agustinBassi-others/juegoSimon/hard/README.md

CREACION DEL ARCHIVO: 30/06/16

AUTOR: Juan Agustin Bassi

Aclaraciones de caracter general para el proyecto "PONCHO SIMON" para la plataforma educativa EDU-CIAA NXP.
