agustinBassi-others/juegoSimon/hard/doc/PONCHO-SIMON Fotos/IMG_20170701_124607375.jpg

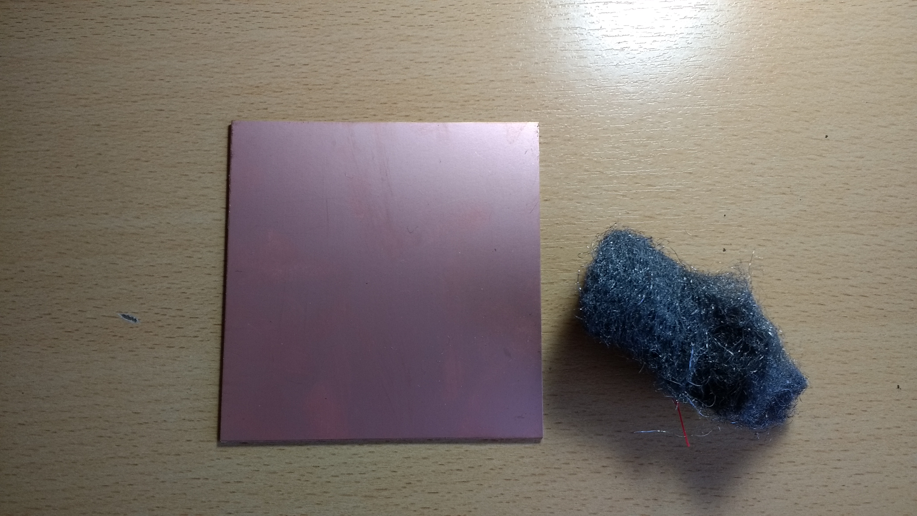
hard/doc/PONCHO-SIMON Fotos/IMG_20170701_124607375.jpg
