agustinBassi-others/juegoSimon/hard/doc/PONCHO-SIMON Fotos/IMG_20170701_125019360.jpg

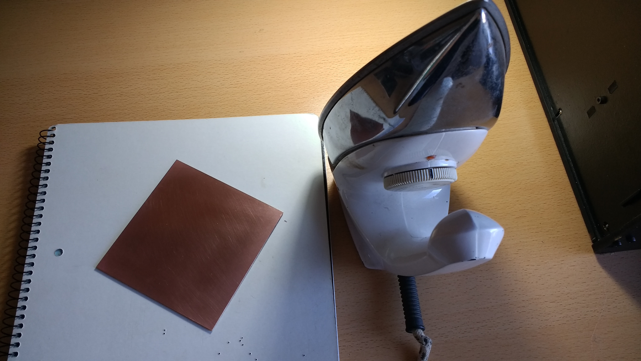
hard/doc/PONCHO-SIMON Fotos/IMG_20170701_125019360.jpg
