agustinBassi-others/juegoSimon/hard/doc/PONCHO-SIMON Fotos/IMG_20170701_125120024.jpg

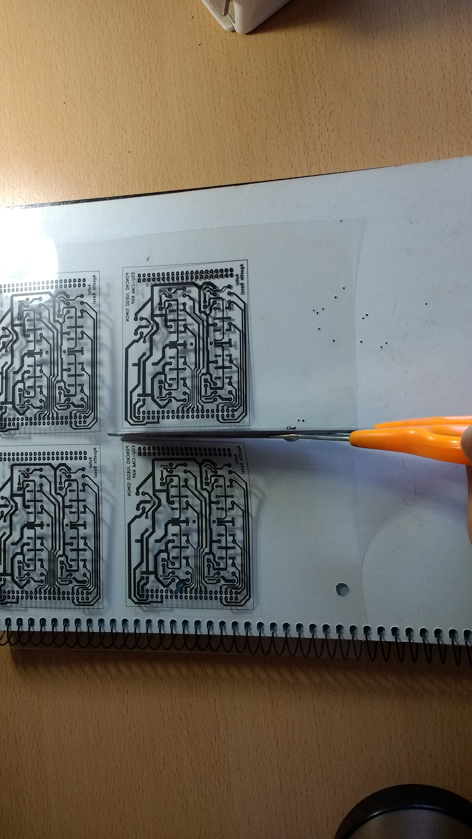
hard/doc/PONCHO-SIMON Fotos/IMG_20170701_125120024.jpg
