agustinBassi-others/juegoSimon/hard/doc/PONCHO-SIMON Fotos/IMG_20170701_125949578.jpg

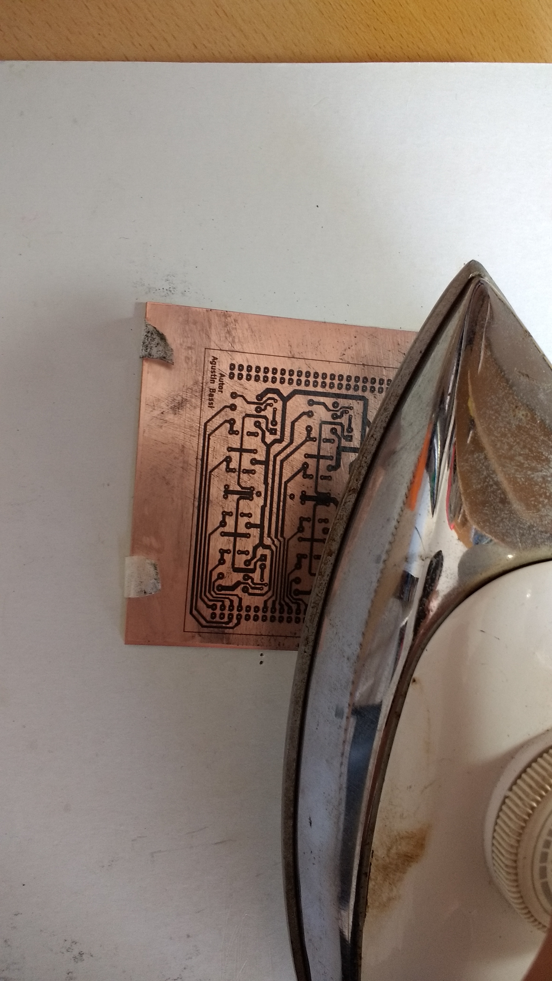
hard/doc/PONCHO-SIMON Fotos/IMG_20170701_125949578.jpg
