agustinBassi-others/juegoSimon/hard/doc/PONCHO-SIMON Fotos/IMG_20170701_130110849.jpg

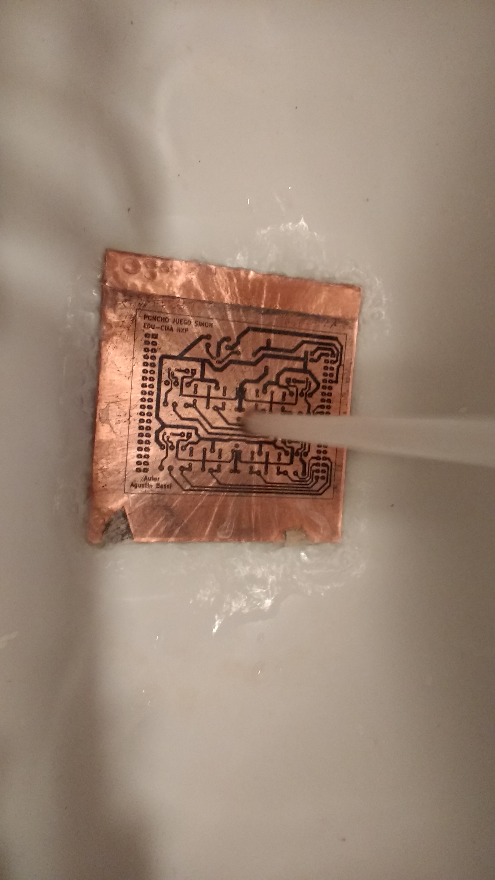
hard/doc/PONCHO-SIMON Fotos/IMG_20170701_130110849.jpg
