agustinBassi-others/juegoSimon/hard/doc/PONCHO-SIMON Fotos/IMG_20170701_134502179_HDR.jpg

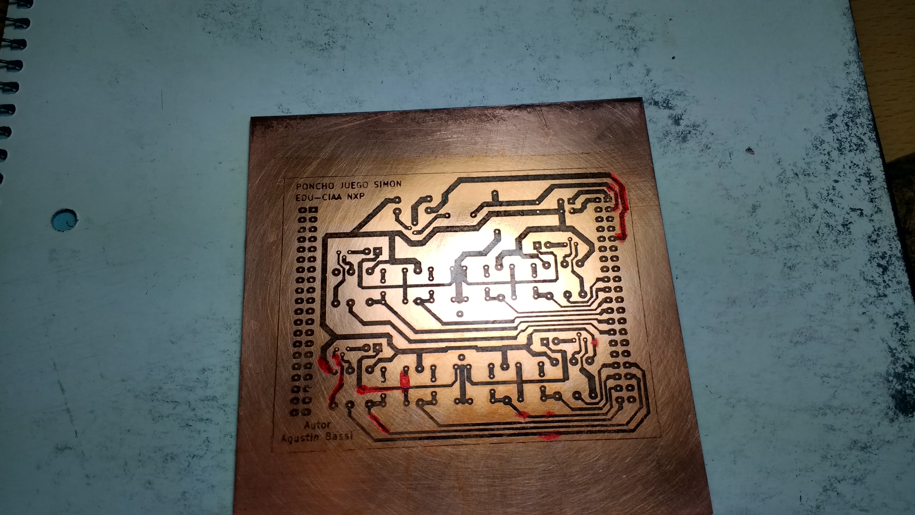
hard/doc/PONCHO-SIMON Fotos/IMG_20170701_134502179_HDR.jpg
