agustinBassi-others/juegoSimon/hard/doc/PONCHO-SIMON Fotos/IMG_20170701_150949867.jpg

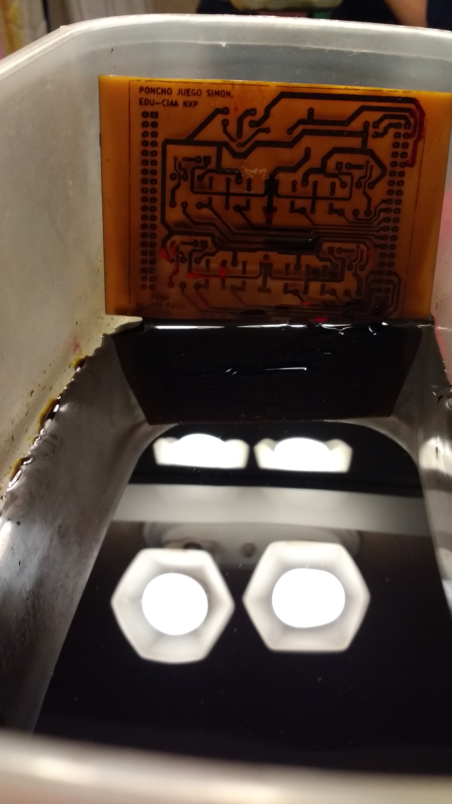
hard/doc/PONCHO-SIMON Fotos/IMG_20170701_150949867.jpg
