agustinBassi-others/juegoSimon/hard/doc/PONCHO-SIMON Fotos/IMG_20170701_150952031.jpg

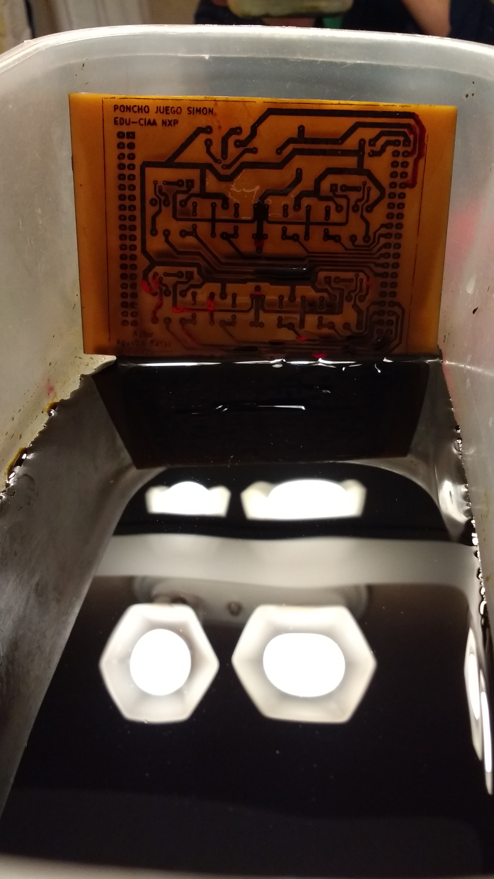
hard/doc/PONCHO-SIMON Fotos/IMG_20170701_150952031.jpg
