agustinBassi-others/juegoSimon/hard/doc/PONCHO-SIMON Fotos/IMG_20170701_153716362.jpg

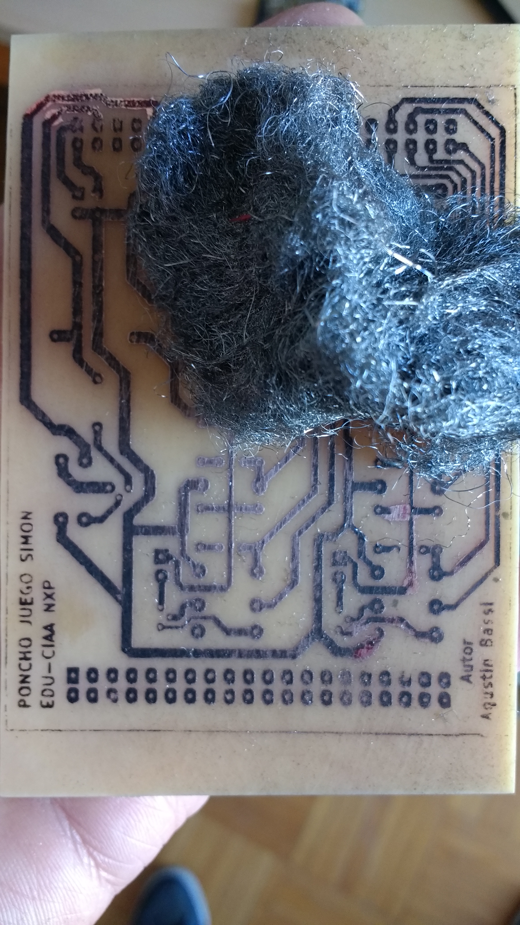
hard/doc/PONCHO-SIMON Fotos/IMG_20170701_153716362.jpg
