agustinBassi-others/juegoSimon/hard/doc/PONCHO-SIMON Fotos/IMG_20170701_154227787.jpg

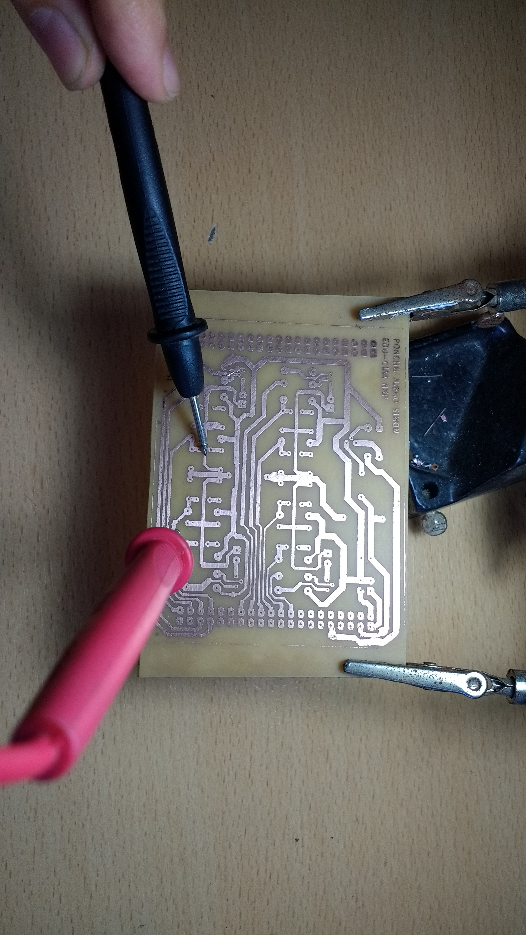
hard/doc/PONCHO-SIMON Fotos/IMG_20170701_154227787.jpg
