agustinBassi-others/juegoSimon/hard/doc/PONCHO-SIMON Fotos/IMG_20170701_154240591.jpg

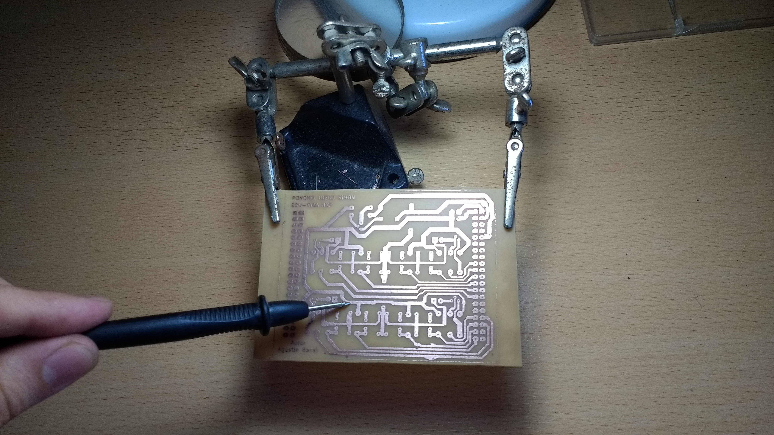
hard/doc/PONCHO-SIMON Fotos/IMG_20170701_154240591.jpg
