agustinBassi-others/juegoSimon/hard/doc/PONCHO-SIMON Fotos/IMG_20170701_154302212.jpg

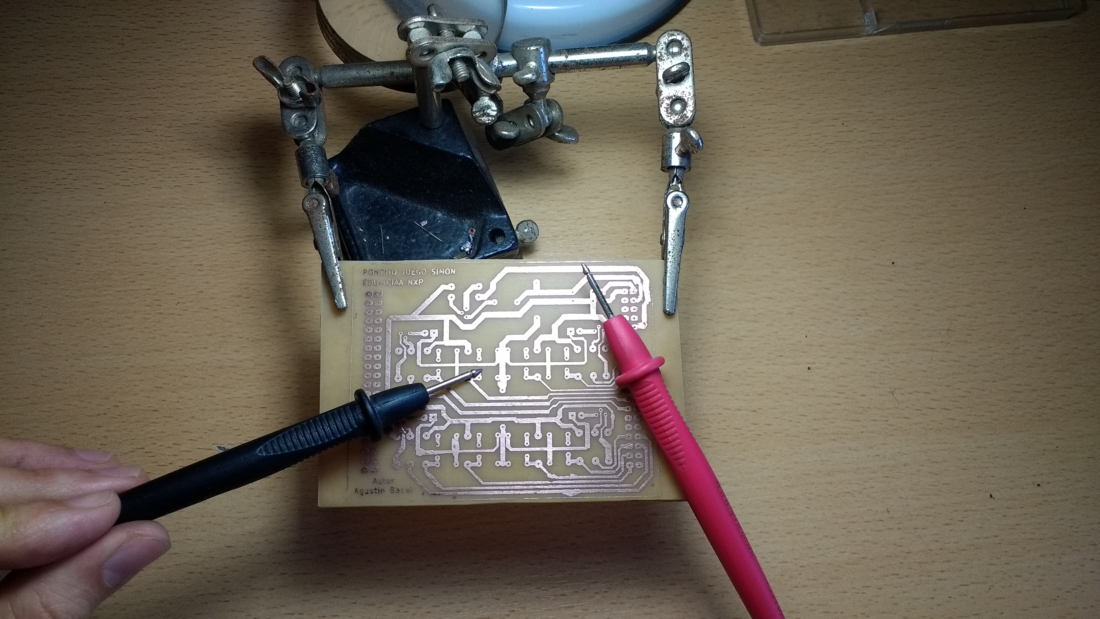
hard/doc/PONCHO-SIMON Fotos/IMG_20170701_154302212.jpg
