agustinBassi-others/juegoSimon/hard/doc/PONCHO-SIMON Fotos/IMG_20170701_155407084.jpg

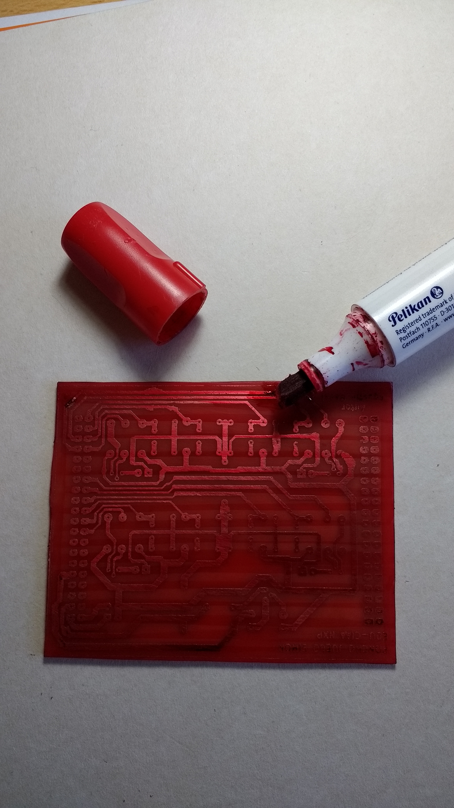
hard/doc/PONCHO-SIMON Fotos/IMG_20170701_155407084.jpg
