agustinBassi-others/juegoSimon/hard/doc/PONCHO-SIMON Fotos/IMG_20170701_160003460.jpg

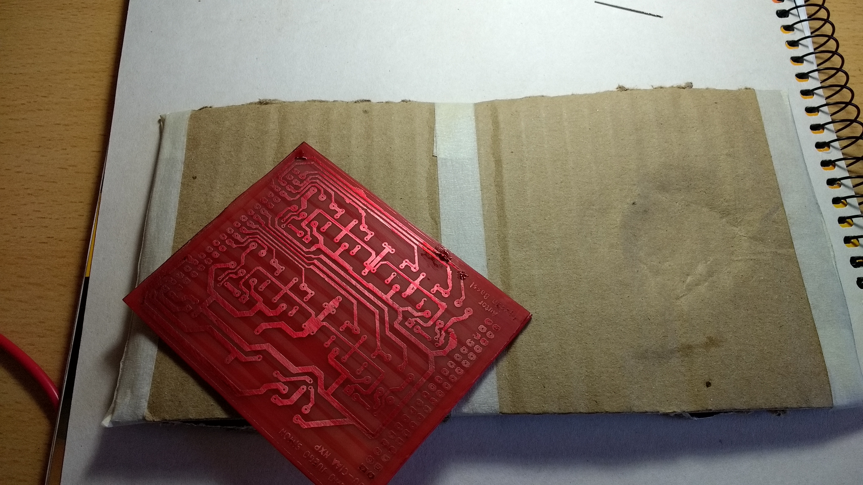
hard/doc/PONCHO-SIMON Fotos/IMG_20170701_160003460.jpg
