agustinBassi-others/juegoSimon/hard/doc/PONCHO-SIMON Fotos/IMG_20170701_162618793.jpg

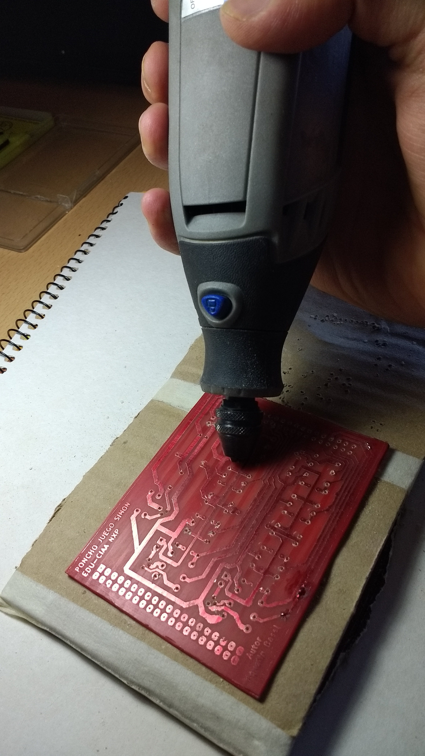
hard/doc/PONCHO-SIMON Fotos/IMG_20170701_162618793.jpg
