agustinBassi-others/juegoSimon/hard/doc/PONCHO-SIMON Fotos/IMG_20170701_185001587.jpg

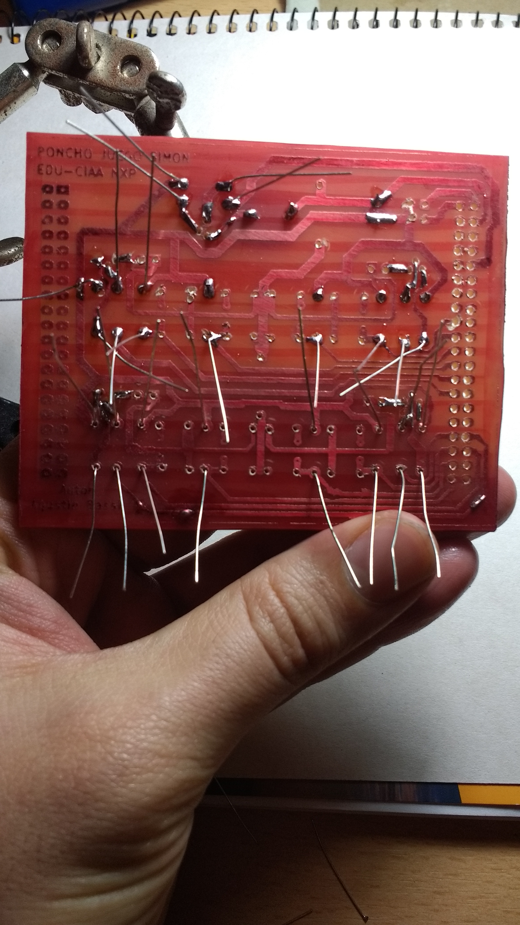
hard/doc/PONCHO-SIMON Fotos/IMG_20170701_185001587.jpg
