agustinBassi-others/juegoSimon/hard/doc/PONCHO-SIMON Fotos/IMG_20170701_185011305_HDR.jpg

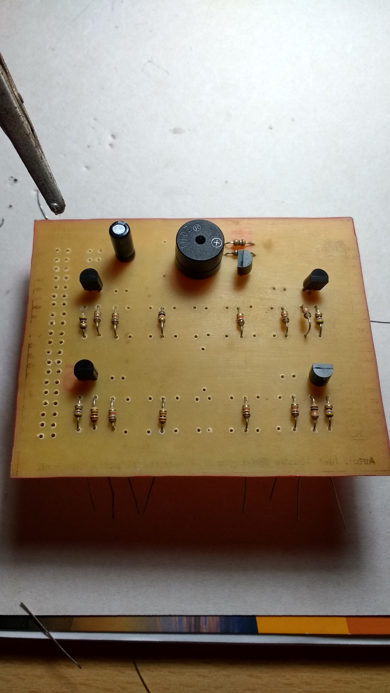
hard/doc/PONCHO-SIMON Fotos/IMG_20170701_185011305_HDR.jpg
