agustinBassi-others/juegoSimon/hard/doc/PONCHO-SIMON Fotos/IMG_20170701_233252299.jpg

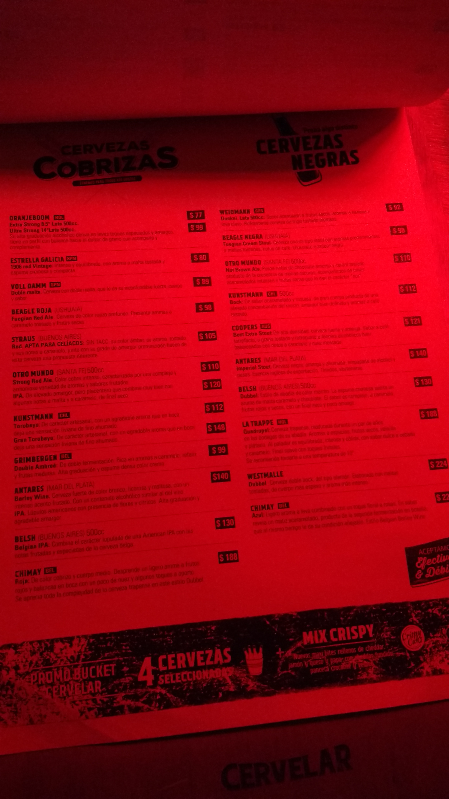
hard/doc/PONCHO-SIMON Fotos/IMG_20170701_233252299.jpg
