agustinBassi-others/juegoSimon/hard/doc/PONCHO-SIMON Fotos/IMG_20170701_233353394.jpg

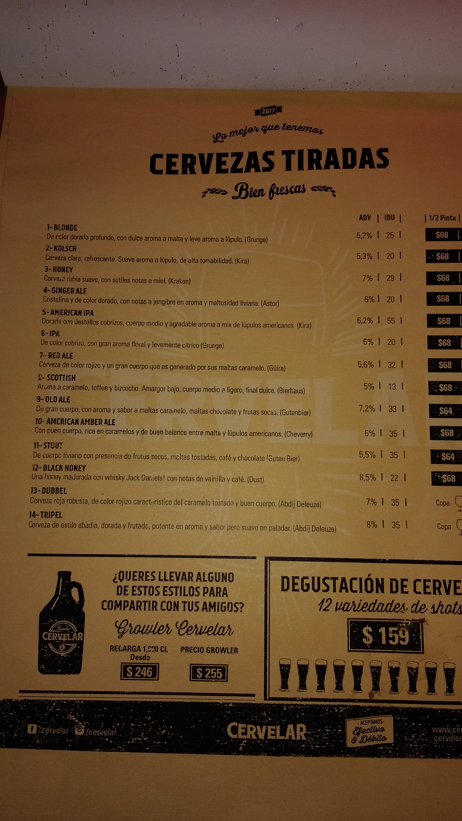
hard/doc/PONCHO-SIMON Fotos/IMG_20170701_233353394.jpg
