agustinBassi-others/juegoSimon/hard/doc/PONCHO-SIMON Fotos/IMG_20170702_172156348.jpg

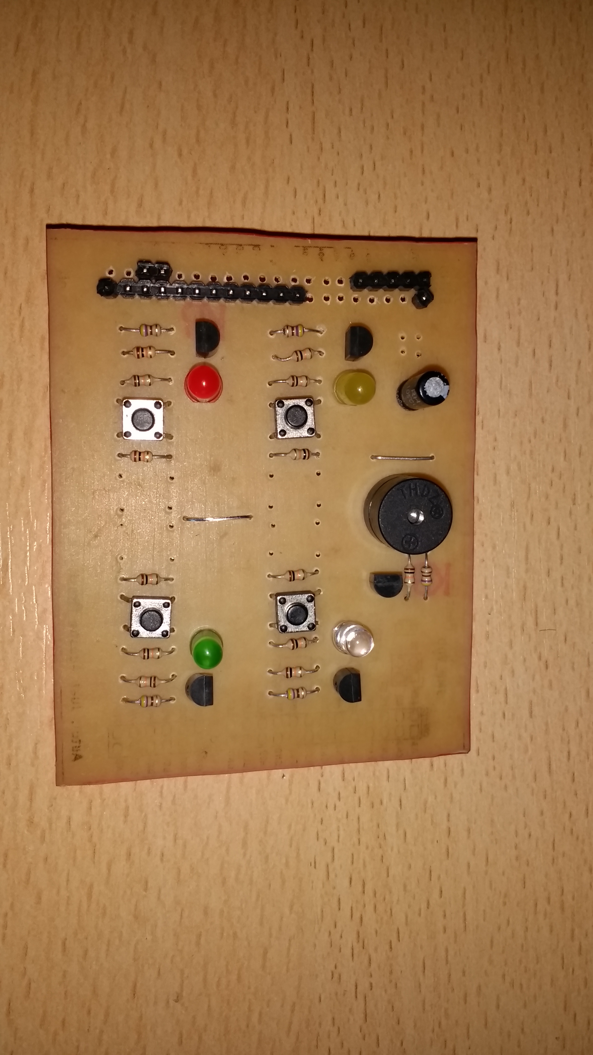
hard/doc/PONCHO-SIMON Fotos/IMG_20170702_172156348.jpg
