agustinBassi-others/juegoSimon/hard/doc/PONCHO-SIMON Fotos/IMG_20170702_172204577.jpg

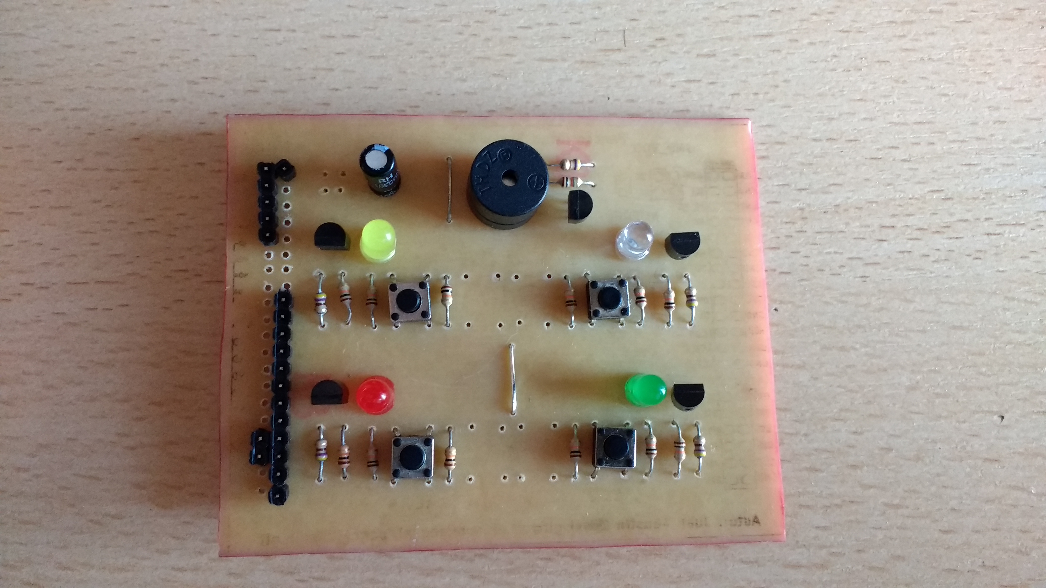
hard/doc/PONCHO-SIMON Fotos/IMG_20170702_172204577.jpg
