agustinBassi-others/juegoSimon/hard/doc/PONCHO-SIMON Fotos/IMG_20170702_184306553.jpg

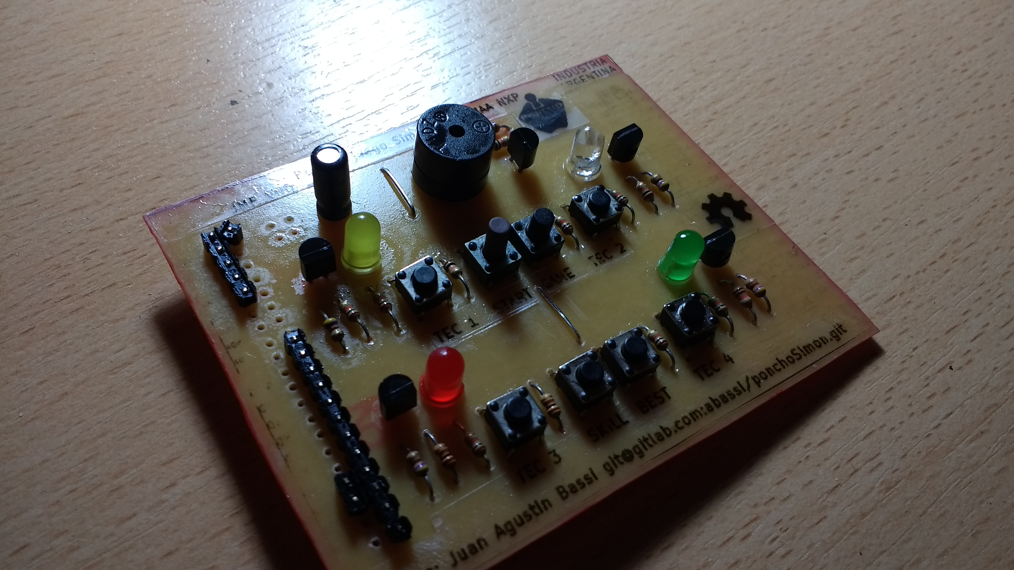
hard/doc/PONCHO-SIMON Fotos/IMG_20170702_184306553.jpg
