agustinBassi-others/juegoSimon/hard/doc/PONCHO-SIMON Fotos/IMG_20170702_184310411.jpg

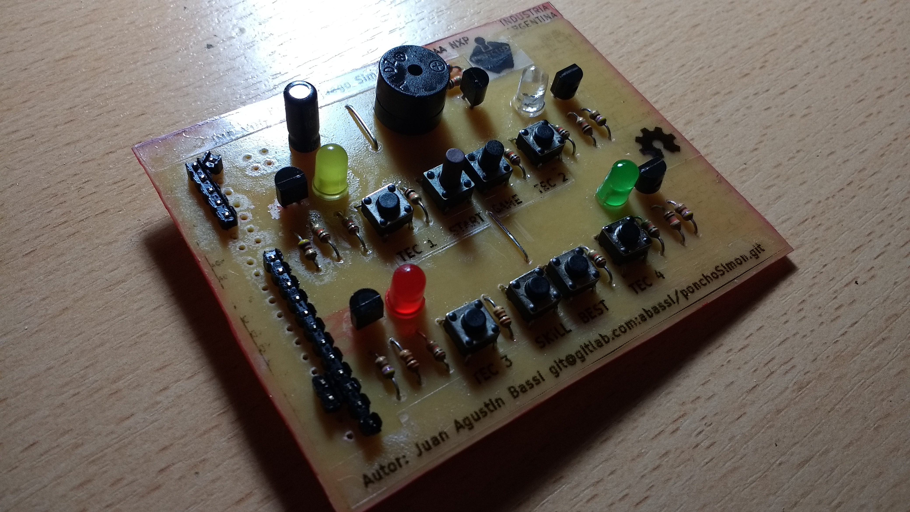
hard/doc/PONCHO-SIMON Fotos/IMG_20170702_184310411.jpg
