agustinBassi-others/juegoSimon/hard/doc/PONCHO-SIMON Fotos/IMG_20170702_185251613.jpg

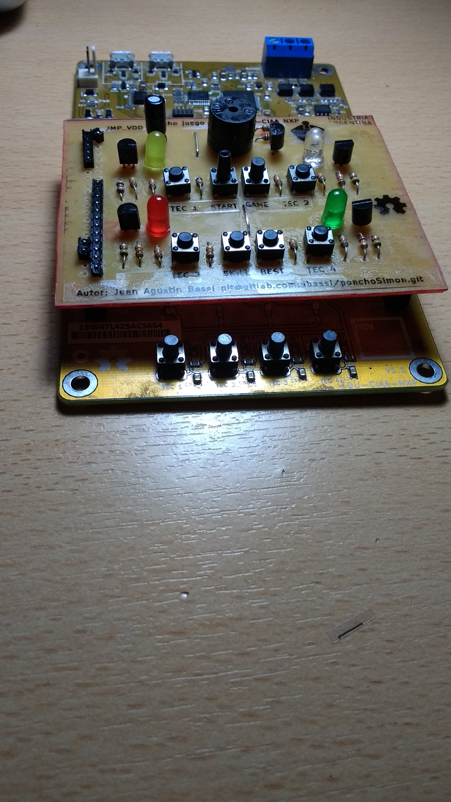
hard/doc/PONCHO-SIMON Fotos/IMG_20170702_185251613.jpg
