agustinBassi-others/juegoSimon/hard/doc/schematic.pdf

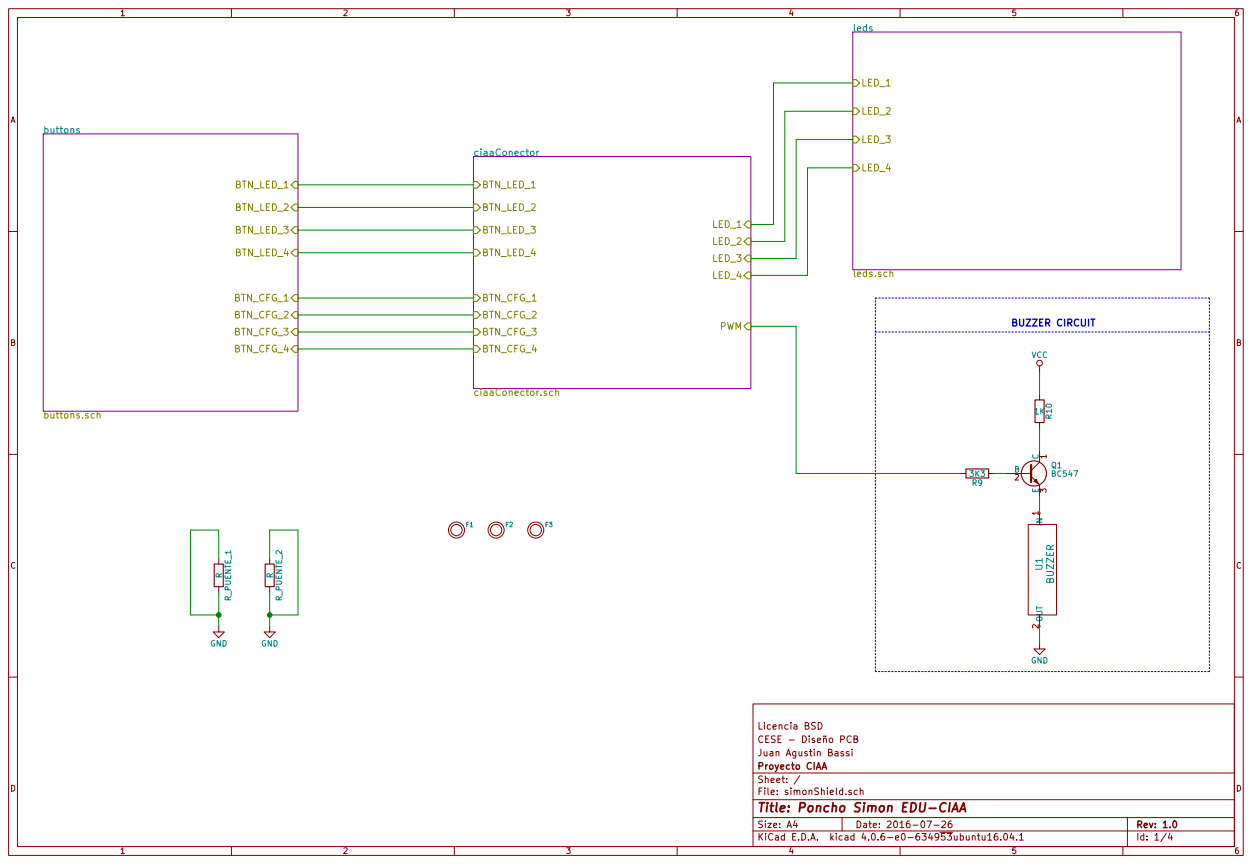
[picture p44: page 1]

Licencia BSD
Juan Agustin Bassi CESE - Diseño PCB

File: simonShield.sch Sheet: / Proyecto CIAA

Id: 1/4 Title: Poncho Simon EDU-CIAA

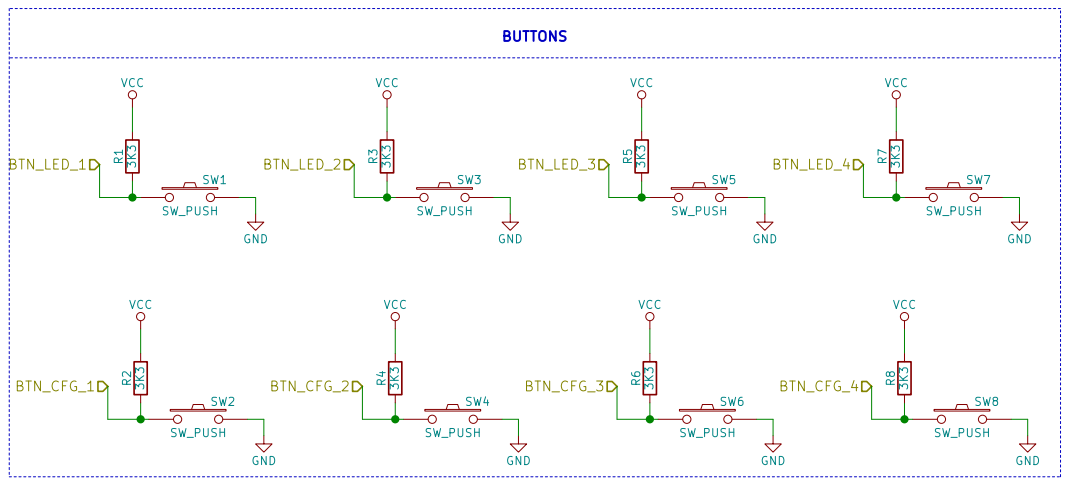
[picture p45: page 2]

Licencia BSD
Juan Agustin Bassi CESE - Diseño PCB

File: buttons.sch Sheet: /buttons/ Proyecto CIAA

Id: 2/4 Title: Poncho Simon EDU-CIAA

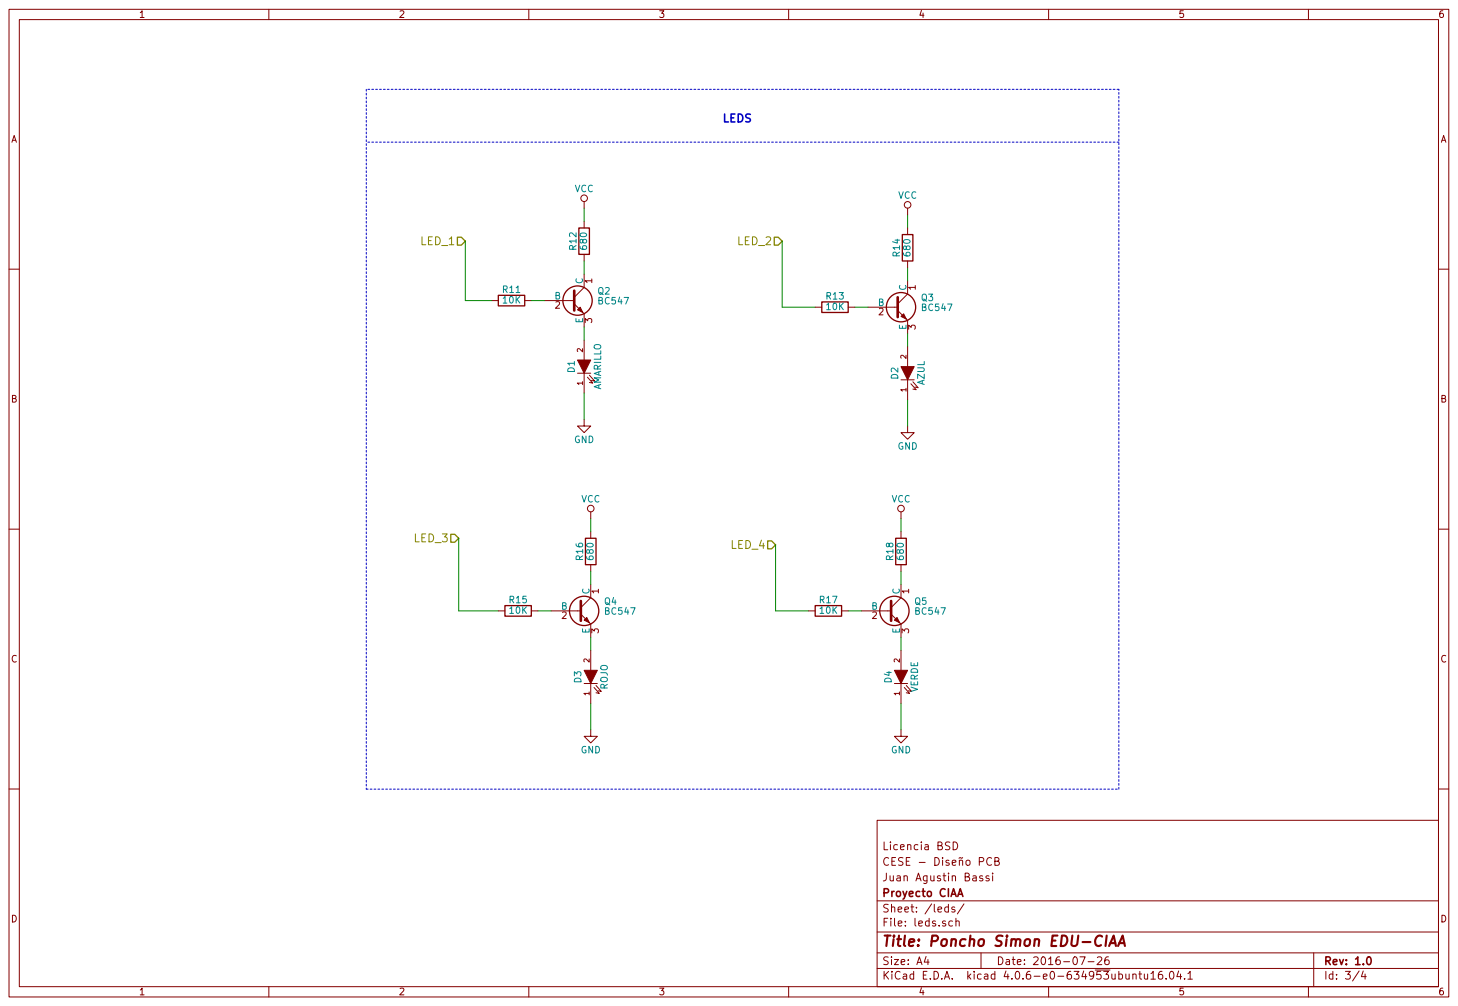
[picture p46: page 3]

Licencia BSD
Juan Agustin Bassi CESE - Diseño PCB

File: leds.sch Sheet: /leds/ Proyecto CIAA

Id: 3/4 Title: Poncho Simon EDU-CIAA

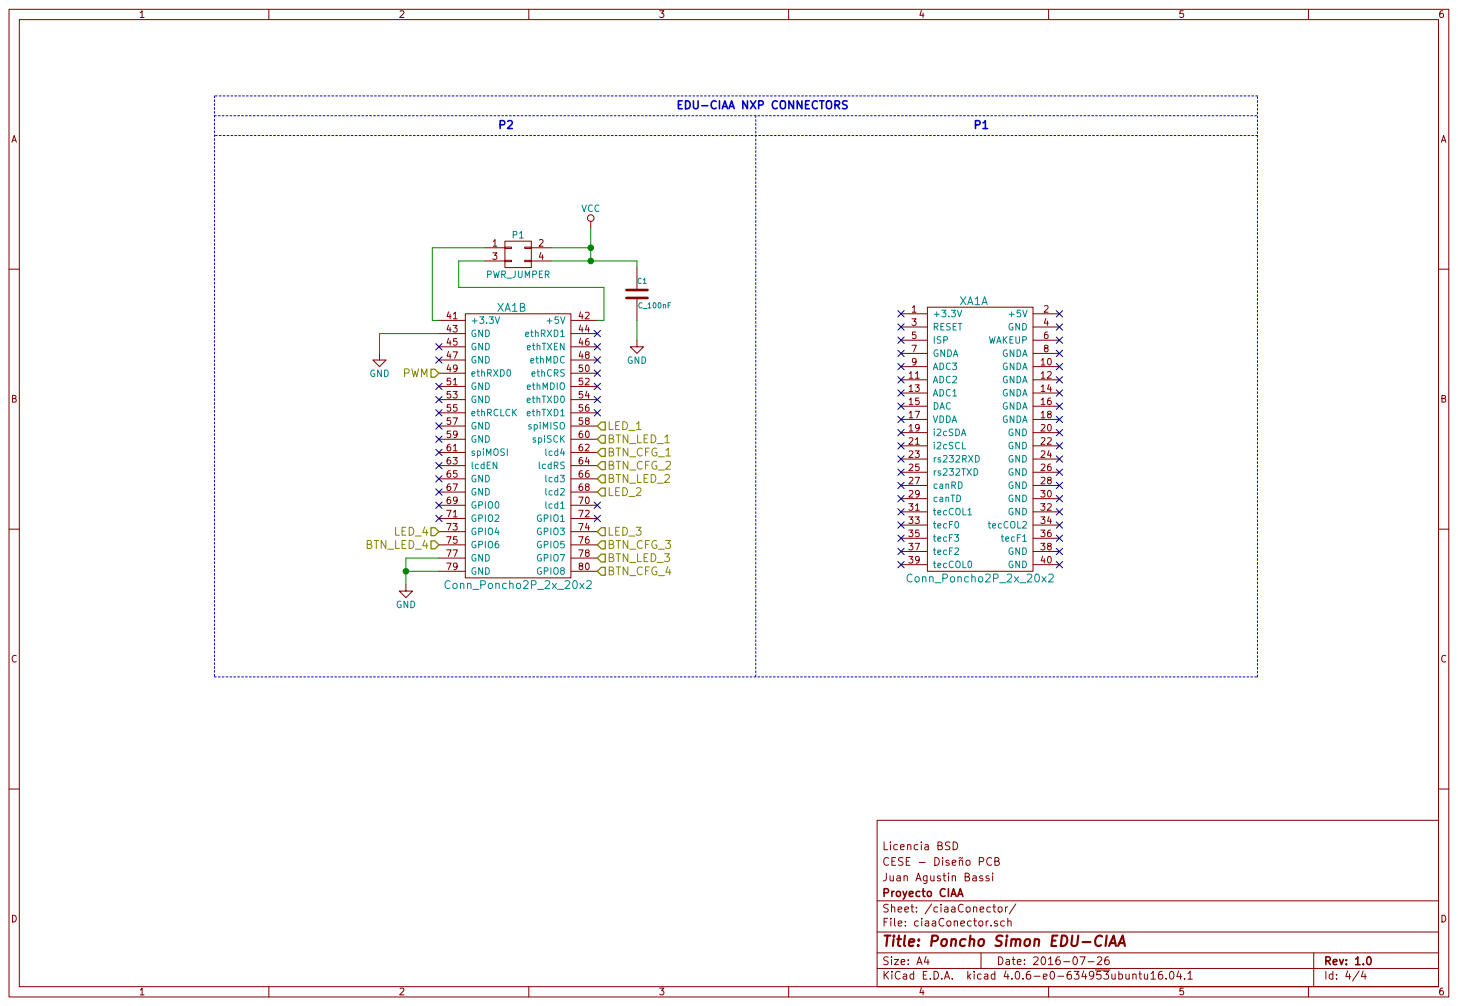
[picture p47: page 4]

EDU-CIAA NXP CONNECTORS

Licencia BSD
Juan Agustin Bassi CESE - Diseño PCB

File: ciaaConector.sch Sheet: /ciaaConector/ Proyecto CIAA

Id: 4/4 Title: Poncho Simon EDU-CIAA
