agustinBassi-others/juegoSimon/hard/gerber/pdf/simonShield-F.SilkS_x6.pdf

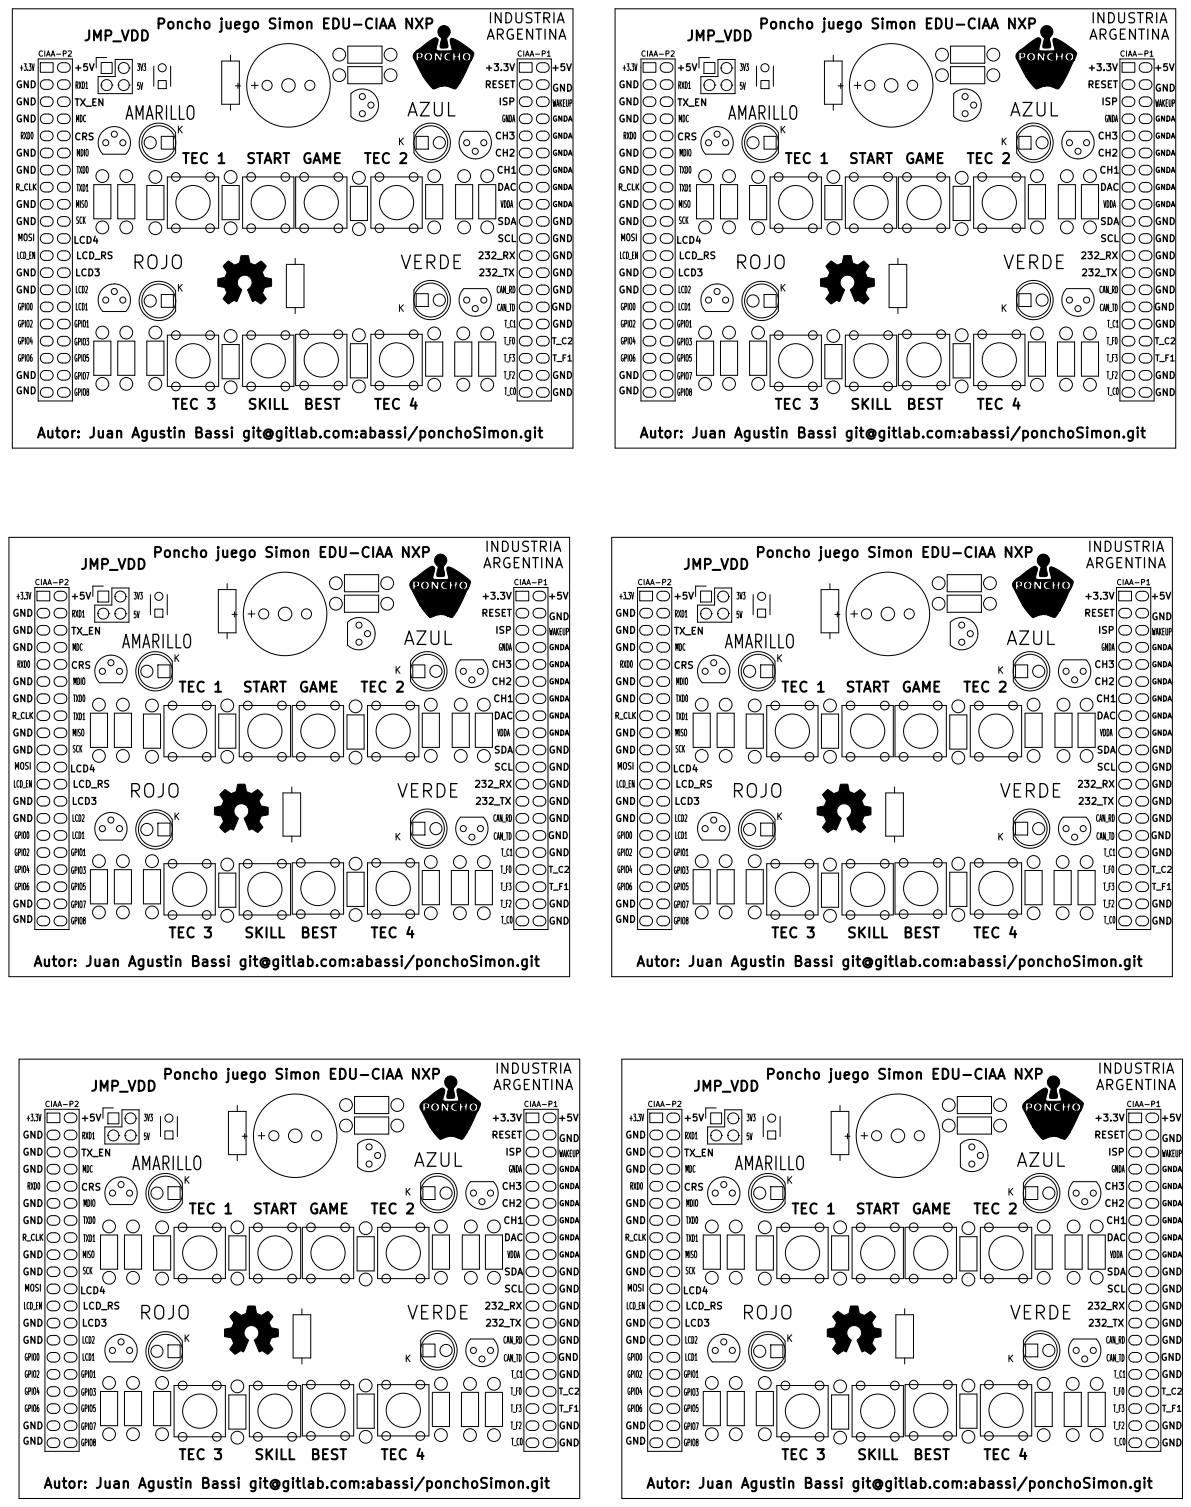
[picture p48: page 1]

INDUSTRIA
ARGENTINA
RXD1 +5V GND GND GPIO6 GPIO4 GPIO2 GPIO0 GND GND
RXD0 GND GND
R_CLK GND GND GND
K GPIO8 GPIO7 GPIO5 GPIO3 GPIO1 LCD1 LCD2 LCD3 LCD_RS
Autor: Juan Agustin Bassi git@gitlab.com:abassi/ponchoSimon.git START GAME

Poncho juego Simon EDU-CIAA NXP

ARGENTINA AMARILLO
JMP_VDD

GNDA GNDA GNDA GNDA GNDA GNDA WAKEUP GND

DAC
VDDA
T_F1 T_C2 GND GND GND GND GND GND GND
