agustinBassi-others/juegoSimon/hard/gerber/pdf/simonShield-B.Cu_x6.pdf

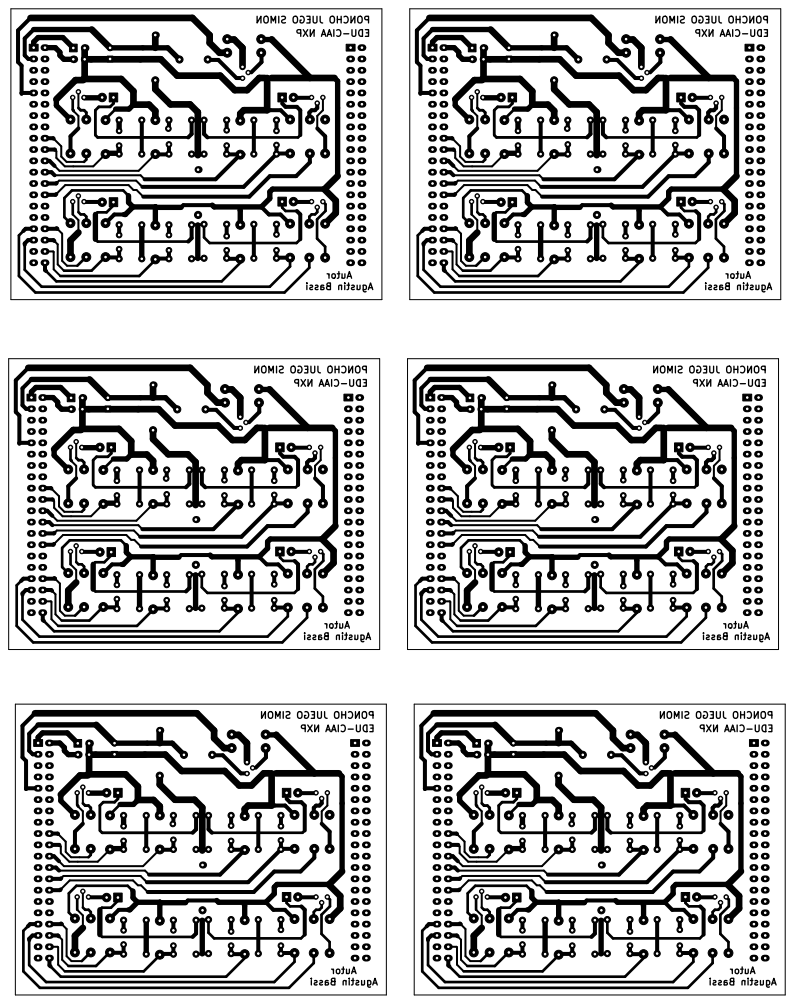
[picture p49: page 1]

EDU-CIAA NXP Autor Agustin Bassi Autor Agustin Bassi EDU-CIAA NXP
