agustinBassi-others/juegoSimon/hard/simonShield.kicad_pcb

## KiCad design hard/simonShield.kicad_pcb (2017-07-07)

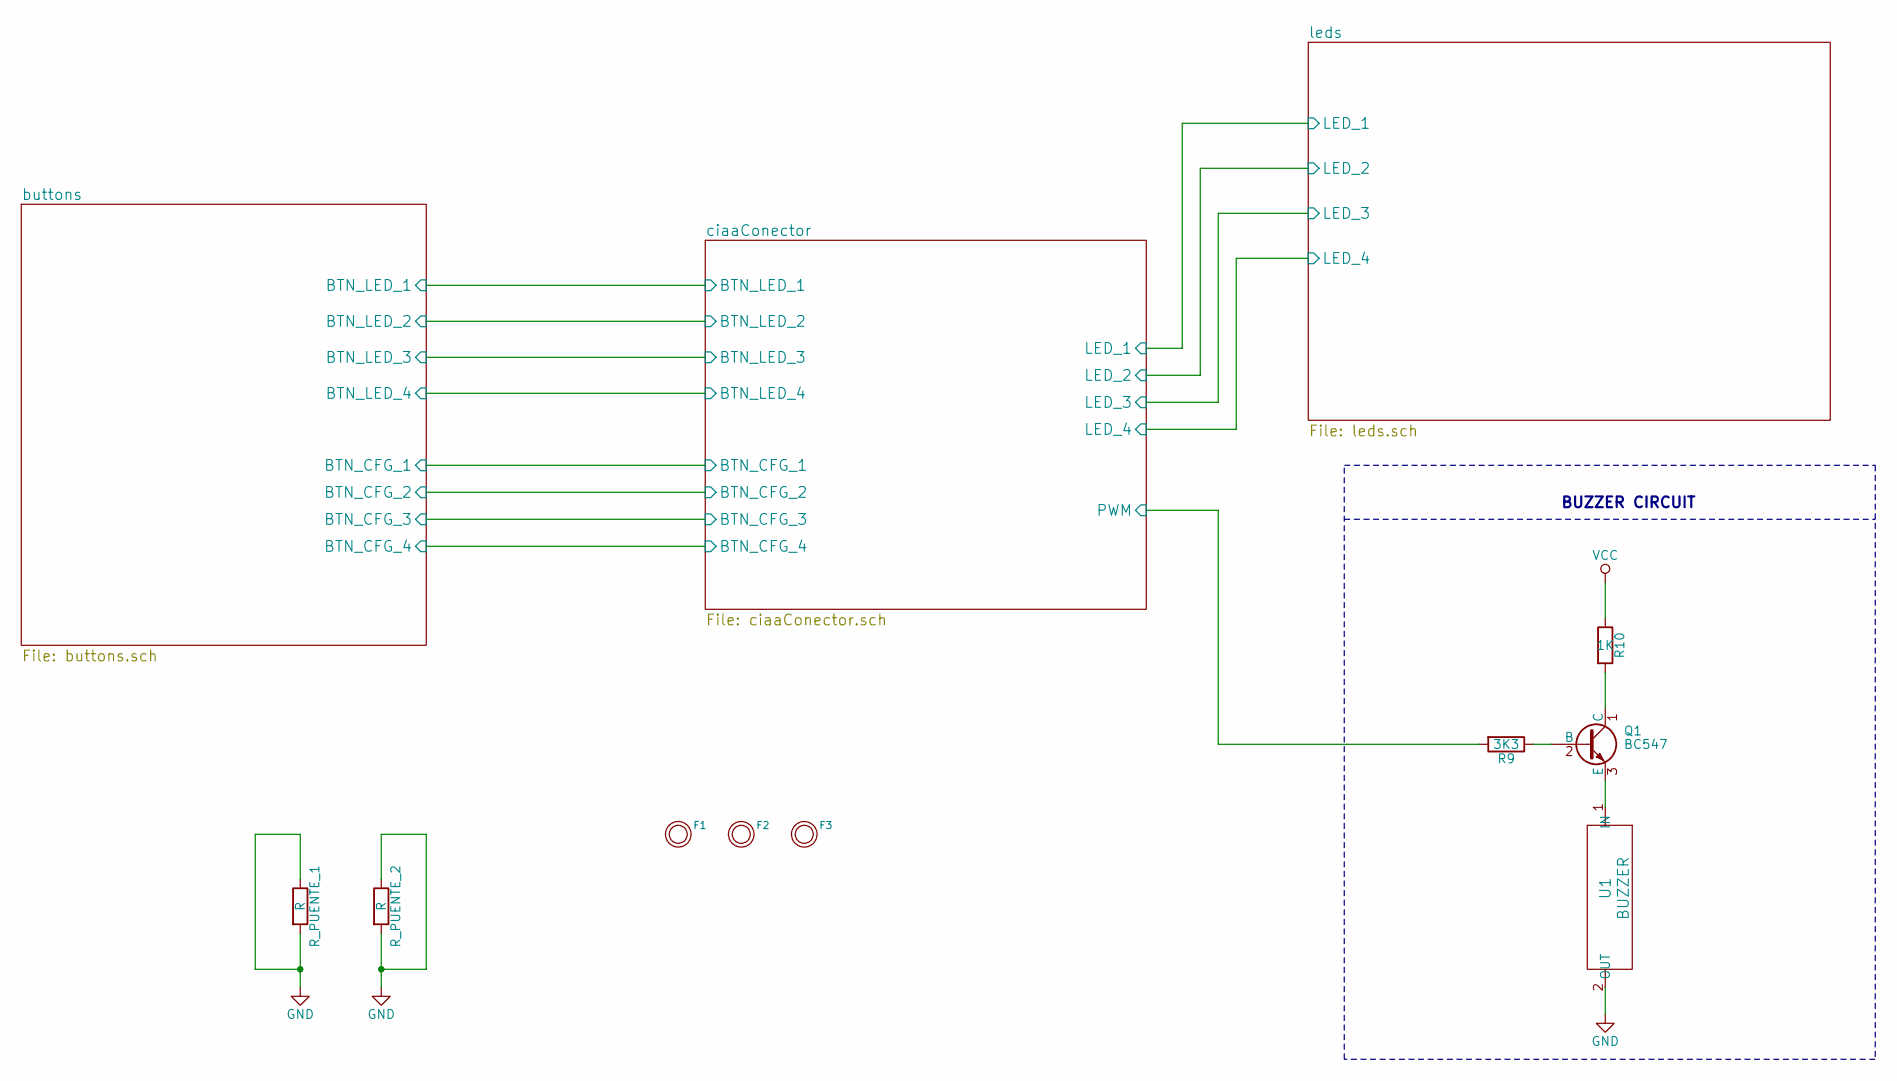
[picture p51: schematic simonShield.sch, Poncho Simon EDU-CIAA]

Parts:
F1, F2, F3: FIDUCIAL; Fiducial_1mm
Q1: BC547; TO-92_Molded_Narrow; Digikey# BC33725TACT-ND
R9: 3K3; Resistor_Horizontal_RM7mm; Digikey# 680EBK-ND
R10: 1K; Resistor_Horizontal_RM7mm; Digikey# 680EBK-ND
R_PUENTE_1, R_PUENTE_2: R; R_Axial_DIN0207_L6.3mm_D2.5mm_P10.16mm_Horizontal
U1: BUZZER; MagneticBuzzer_ProSignal_ABT-410-RC; Digikey# 445-2525-1-ND

Connections:
/ciaaConector/PWM: R9.2; also elsewhere on the board
GND: R_PUENTE_1.1, R_PUENTE_1.2, R_PUENTE_2.1, R_PUENTE_2.2, U1.2 (OUT); also elsewhere on the board
unnamed: Q1.1 (C), R10.2
unnamed: Q1.2 (B), R9.1
unnamed: Q1.3 (E), U1.1 (IN)
VCC: R10.1; also elsewhere on the board

Notes on the sheet:
BUZZER CIRCUIT

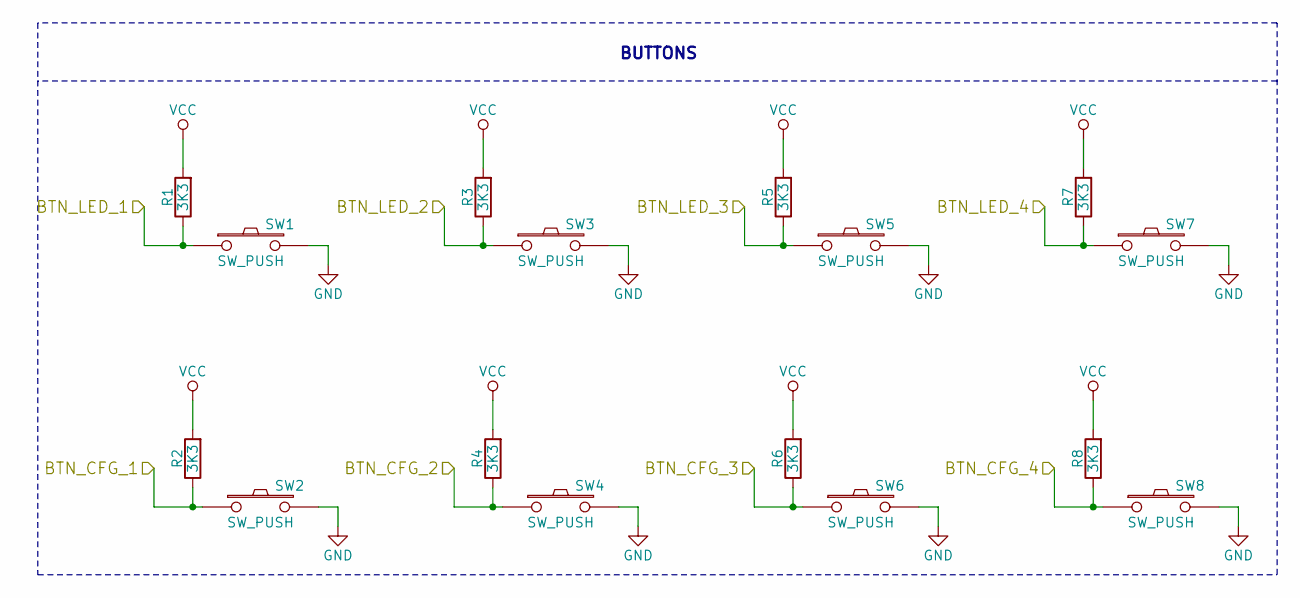
[picture p52: schematic buttons.sch, Poncho Simon EDU-CIAA]

Parts:
R1, R2, R3, R4, R5, R6, R7, R8: 3K3; Resistor_Horizontal_RM7mm; Digikey# 680EBK-ND
SW1, SW2, SW3, SW4, SW5, SW6, SW7, SW8: SW_PUSH; SW_PUSH_SMALL; Digikey# 450-1804-ND

Connections:
/buttons/BTN_CFG_1: R2.1, SW2.1; also elsewhere on the board
/buttons/BTN_CFG_2: R4.1, SW4.1; also elsewhere on the board
/buttons/BTN_CFG_3: R6.1, SW6.1; also elsewhere on the board
/buttons/BTN_CFG_4: R8.1, SW8.1; also elsewhere on the board
/buttons/BTN_LED_1: R1.1, SW1.1; also elsewhere on the board
/buttons/BTN_LED_2: R3.1, SW3.1; also elsewhere on the board
/buttons/BTN_LED_3: R5.1, SW5.1; also elsewhere on the board
/buttons/BTN_LED_4: R7.1, SW7.1; also elsewhere on the board
GND: SW1.2, SW2.2, SW3.2, SW4.2, SW5.2, SW6.2, SW7.2, SW8.2; also elsewhere on the board
VCC: R1.2, R2.2, R3.2, R4.2, R5.2, R6.2, R7.2, R8.2; also elsewhere on the board

Notes on the sheet:
BUTTONS

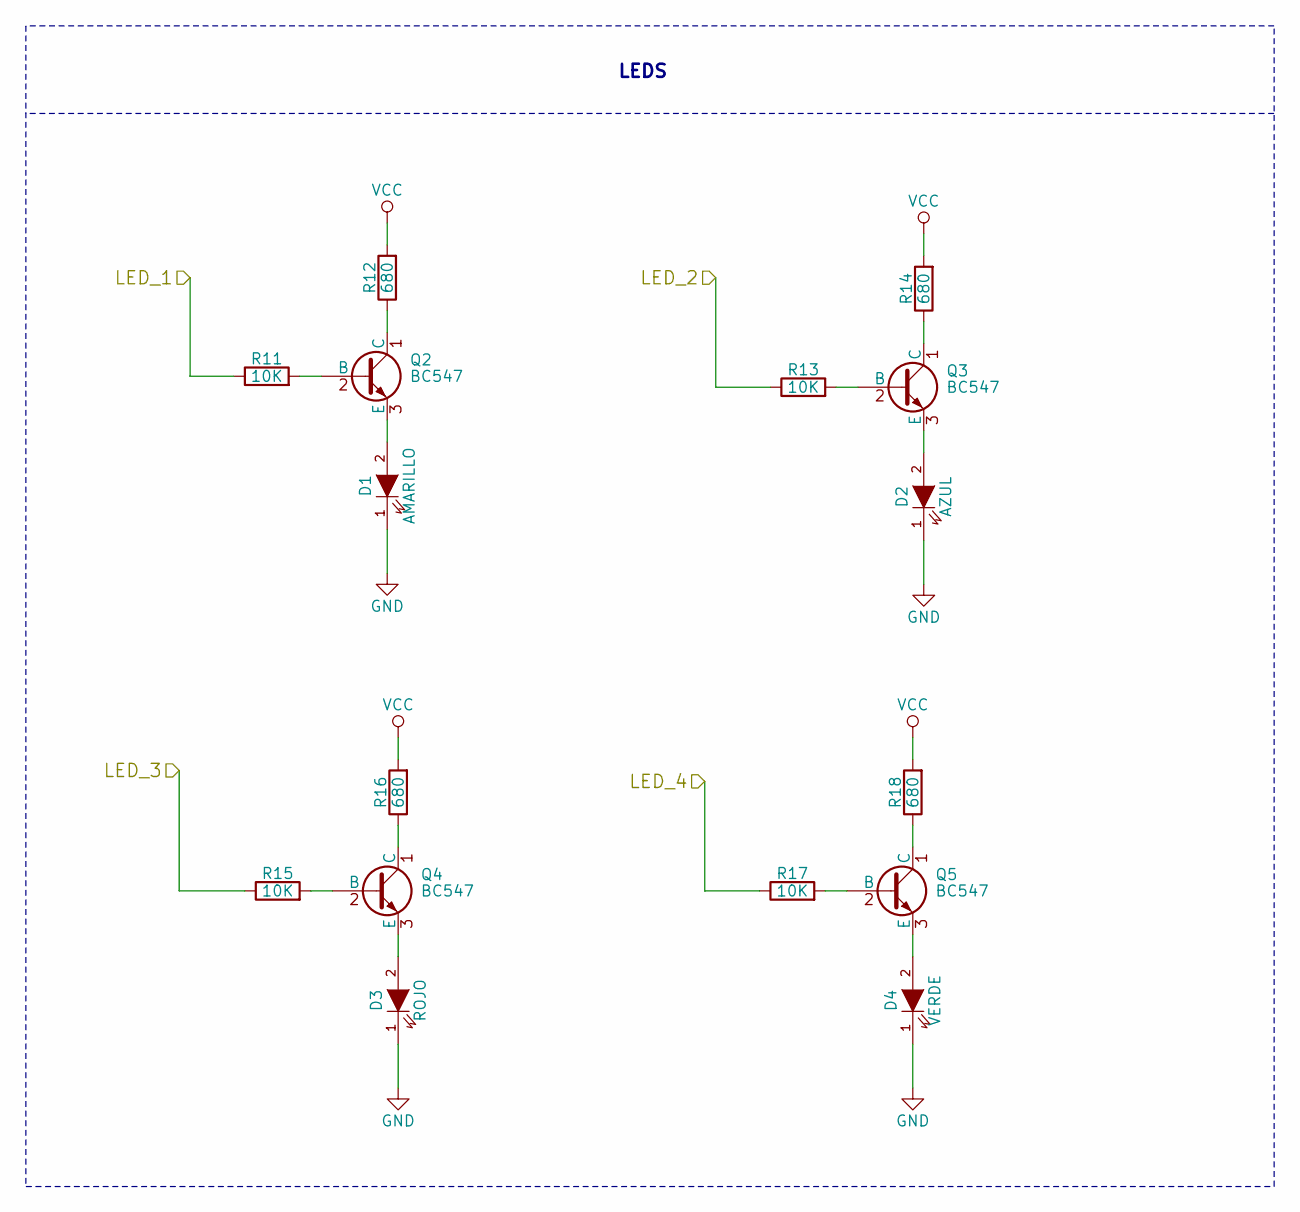
[picture p53: schematic leds.sch, Poncho Simon EDU-CIAA]

Parts:
D1: AMARILLO; LED-5MM; Digikey# 1497-1031-ND
D2: AZUL; LED-5MM; Digikey# 1497-1031-ND
D3: ROJO; LED-5MM; Digikey# 1497-1031-ND
D4: VERDE; LED-5MM; Digikey# 1497-1031-ND
Q2, Q3, Q4, Q5: BC547; TO-92_Molded_Narrow; Digikey# BC33725TACT-ND
R11, R13, R15, R17: 10K; Resistor_Horizontal_RM7mm; Digikey# 680EBK-ND
R12, R14, R16, R18: 680; Resistor_Horizontal_RM7mm; Digikey# 680EBK-ND

Connections:
/ciaaConector/LED_1: R11.1; also elsewhere on the board
/ciaaConector/LED_2: R13.1; also elsewhere on the board
/ciaaConector/LED_3: R15.1; also elsewhere on the board
/ciaaConector/LED_4: R17.1; also elsewhere on the board
GND: D1.1 (K), D2.1 (K), D3.1 (K), D4.1 (K); also elsewhere on the board
unnamed: D1.2 (A), Q2.3 (E)
unnamed: D2.2 (A), Q3.3 (E)
unnamed: D3.2 (A), Q4.3 (E)
unnamed: D4.2 (A), Q5.3 (E)
unnamed: Q2.1 (C), R12.1
unnamed: Q2.2 (B), R11.2
unnamed: Q3.1 (C), R14.1
unnamed: Q3.2 (B), R13.2
unnamed: Q4.1 (C), R16.1
unnamed: Q4.2 (B), R15.2
unnamed: Q5.1 (C), R18.1
unnamed: Q5.2 (B), R17.2
VCC: R12.2, R14.2, R16.2, R18.2; also elsewhere on the board

Notes on the sheet:
LEDS

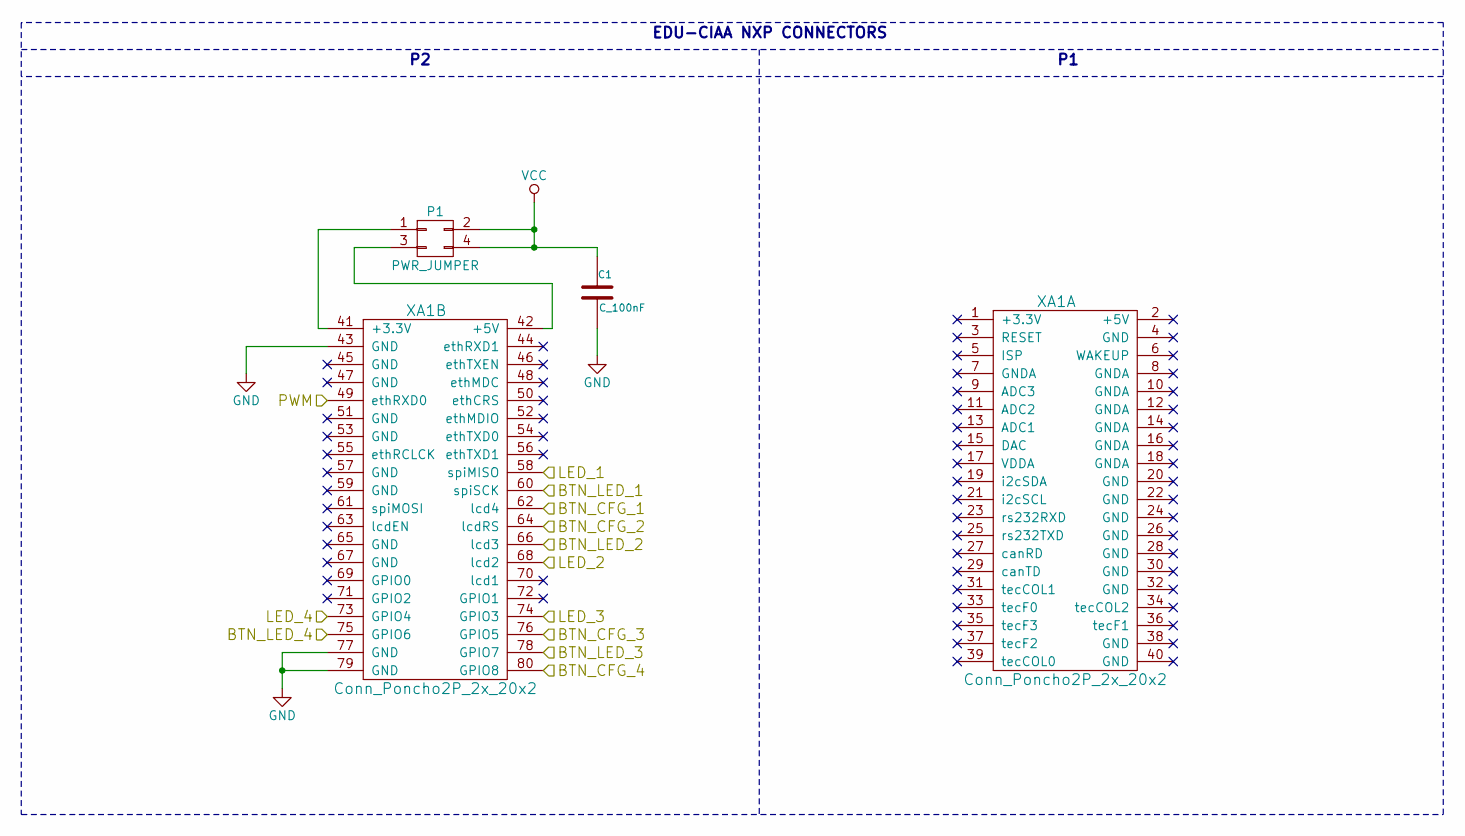
[picture p54: schematic ciaaConector.sch, Poncho Simon EDU-CIAA]

Parts:
C1: C_100nF; C_Disc_D3_P2.5; Digikey# BC1160TR­ND
P1: PWR_JUMPER; Pin_Header_Straight_2x02; Digikey# 952-2121-ND
XA1: Conn_Poncho2P_2x_20x2; Conn_Poncho_SinBorde; Digikey# 952-2121-ND

Connections:
/buttons/BTN_CFG_1: XA1.62 (lcd4); also elsewhere on the board
/buttons/BTN_CFG_2: XA1.64 (lcdRS); also elsewhere on the board
/buttons/BTN_CFG_3: XA1.76 (GPIO5); also elsewhere on the board
/buttons/BTN_CFG_4: XA1.80 (GPIO8); also elsewhere on the board
/buttons/BTN_LED_1: XA1.60 (spiSCK); also elsewhere on the board
/buttons/BTN_LED_2: XA1.66 (lcd3); also elsewhere on the board
/buttons/BTN_LED_3: XA1.78 (GPIO7); also elsewhere on the board
/buttons/BTN_LED_4: XA1.75 (GPIO6); also elsewhere on the board
/ciaaConector/LED_1: XA1.58 (spiMISO); also elsewhere on the board
/ciaaConector/LED_2: XA1.68 (lcd2); also elsewhere on the board
/ciaaConector/LED_3: XA1.74 (GPIO3); also elsewhere on the board
/ciaaConector/LED_4: XA1.73 (GPIO4); also elsewhere on the board
/ciaaConector/PWM: XA1.49 (ethRXD0); also elsewhere on the board
GND: C1.2, XA1.43 (GND), XA1.77 (GND), XA1.79 (GND); also elsewhere on the board
unnamed: P1.1, XA1.41 (+3.3V)
unnamed: P1.3, XA1.42 (+5V)
VCC: C1.1, P1.2, P1.4; also elsewhere on the board

Notes on the sheet:
EDU-CIAA NXP CONNECTORS

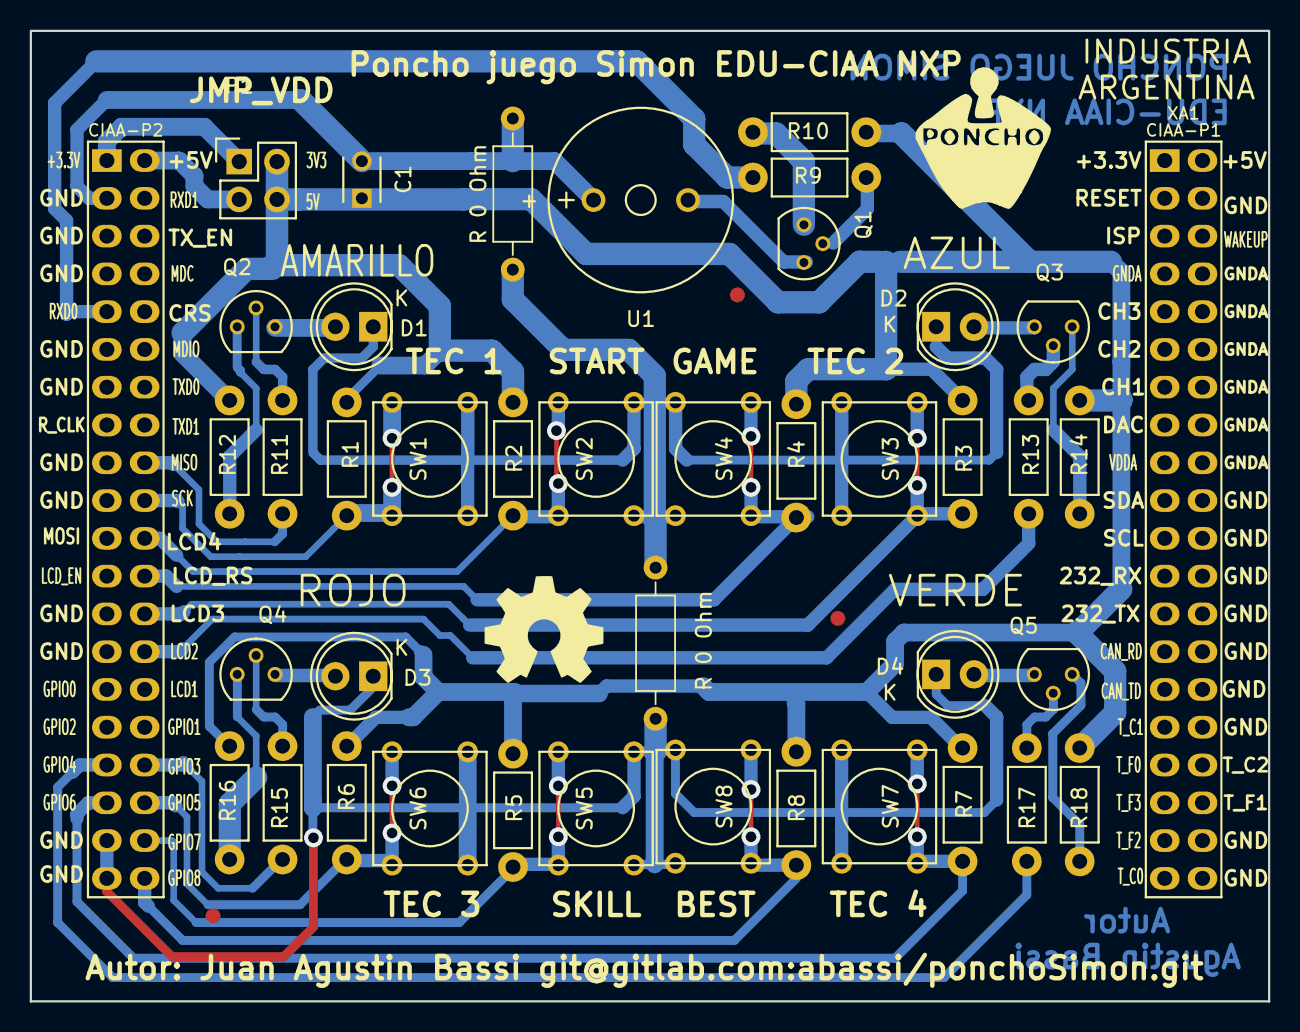
[picture p55: board simonShield.kicad_pcb from above]

Board: 2 copper layers, 83.2 x 65.2 mm, 45 parts (0 on the bottom side), 32 nets.

Other parts of the board:
G101: Logo_OSHWA
R 0 Ohm, R 0 Ohm#2: R; R_Axial_DIN0207_L6.3mm_D2.5mm_P10.16mm_Horizontal

Their connections:
GND: R 0 Ohm.1, R 0 Ohm.2, R 0 Ohm#2.1, R 0 Ohm#2.2; also elsewhere on the board
