agustinBassi-others/juegoSimon/(commit log)

2017-07-01 Version 1 practicamente terminada de poncho Simon con EDU CIAA.
    [bom_new.ods, ciaaConector.sch, simonShield.kicad_pcb, simonShield.sch]
2017-07-01 Version luego de cambiar los pines y agregar dos resistencias de puentes.@
    [ciaaConector.sch, simonShield.kicad_pcb, simonShield.sch]
2017-07-01 Version totalmente ruteada. Previo a hacer puentes con resistencia y a serigrafia.
    [buttons.sch, ciaaConector.sch, leds.sch, simonShield.kicad_pcb, simonShield.sch]
2017-07-01 Commit de acomodo de directorio. Previo a generar los gerbers de fabricacion final.
    [bom.csv, bom.ods, bom.xlsx, bom_new.ods, revision2.ods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]
2017-07-01 Version final de la feature del Poncho Simon para realizarlo con la plancha.
    [simonShield-B.Cu.gbr, simonShield-B.Mask.gbr, simonShield-Edge.Cuts.gbr, simonShield-F.Cu.gbr, simonShield-F.Mask.gbr, simonShield-F.SilkS.gbr, simonShield-drl_map.gbr]
2017-07-07 Acomodo del directorio agregando la carpeta firmware, case y doc.
    [BoulderCreekMotherBoard.xlsx, Indium_X2.xlsx, StickIt-Hat.xlsx, StickIt-QuadDAC.kicad_pcb, StickIt-QuadDAC.sch, StickIt-QuadDAC.xlsx, TestParts.xlsx, _saved_StickIt-QuadDAC.sch]
2017-07-07 Agrega los nuevos archivos de firmware y agrega toda la carpeta hard.
    [BOM.ods, BoulderCreekMotherBoard.xlsx, Indium_X2.xlsx, StickIt-Hat.xlsx, StickIt-QuadDAC.kicad_pcb, StickIt-QuadDAC.sch, StickIt-QuadDAC.xlsx, TestParts.xlsx]
2017-07-08 Primera Version usable en HW. Cambio de pin TECLA_AMARILLO. Tecla SKILL y ROJA detectadas iguales.
2017-07-08 Segunda version usable. Estados definidos y funcionalidad de delay con skill funcionando.
