agustinBassi-others/juegoSimon/(notices)

Notices in the files:
hard/tools/kicost-0.1.25/tests/_saved_StickIt-QuadDAC.sch:
(c) 2016
CC BY 4.0
